DashBarkHuss/dreamphone/(threads)

Thread 1 (2021-04-27):

Dream phone shuts off after a few hours of use

DashBarkHuss, 2021-04-27:
Investigated this issue and seems that the 9V battery can't handle the dream phone.

Tested the current of Dream Phone. Even without LEDs going, it was around 100 mA with used battery, 108mA with a new battery.

108mA is higher than I anticipated. 100 mA would drain a 9V battery, which typically have 500mAh, in 5 hours.

The used 9V battery was drained, volts reading 7.51 V.

I think a solution would be a rechargeable 9V battery that holds at least 1300mAH. (110mA * 12 hours). The highest I'm seeing is [850mAh](https://www.amazon.com/Rechargeable-Batteries-Pallus-Microphones-Flashlights/dp/B08MXQGN21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). Need to investigate more.

DashBarkHuss, 2021-04-27:
The 850mAh option would just be cutting it and probably turn off right before waking. 850mAh/108mA= 7.87 Hours. But this doesn't factor in the extra current mAh used from LED's blinking.

DashBarkHuss, 2021-04-27:
Options:

-[7.4V 2.2AH rechargeable](https://www.digikey.com/en/products/detail/sparkfun-electronics/PRT-11856/5271296)
-[7.2V 3.25AH rechargable](https://www.digikey.com/en/products/detail/jauch-quartz/LI18650PBF-2S1P-PCM-WIRE/9560970)

I've heard that arduino is best powered by between 12v-7v so these might be ok

DashBarkHuss, 2021-05-02:
To repeat it seems I need a **battery that is:**
- Rechargeable
- 1ah or more
- 7-12V
- should charge within 12 hours in time for night time.

This article on different [types of batteries](https://learn.sparkfun.com/tutorials/battery-technologies) suggested LiPo batteries. I like that they have built intprotection against being discharged too much:
>LiPo batteries can also be harmed by being discharged too far. To protect against this, almost all LiPo batteries have a small safety circuit built into the top of the cell that will shut off the battery if the voltage drops below a certain threshold (usually 3V).

The lipo's they talked about have 3.4 V. To get my required minimum of 7v,  could create a battery bank (_I think, but I am new to that concept_) to add the voltage together. But I did see some 7.4V lipo's on amazon. [Here's one](https://www.amazon.com/Zeee-Batteries-Dean-Style-Connector-Vehicles/dp/B076Z778MJ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) but:

- does it have that safety circuit built in that sparkfun mentioned?
- How long does it take to charge?
- It says it's meant for a car. Is that ok?

DashBarkHuss, 2021-05-06:
Need to test the forward voltage of the led's before getting the 7v bateries. The LED strip is 12v. It works at 9 but 7 may be to low.

DashBarkHuss, 2021-05-07:
The [7.4V lipo's](https://www.amazon.com/Zeee-Batteries-Dean-Style-Connector-Vehicles/dp/B076Z778MJ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) were too expensive and bulky. You had to buy a bulky expensive lipo charger with it. So instead I went with these [9V 800mAh](https://www.amazon.com/dp/B087TPNY2D?psc=1&smid=A2B326YBM4EX4P&ref_=chk_typ_imgToDp) batteries.  The have a built in circuit to prevent overcharging. I will make a battery bank in [parallel](https://www.batterystuff.com/kb/articles/battery-articles/battery-bank-tutorial.html) to get more amp hours out of them.

They are lithium-ion. There's a possibility of combustion. But the built-in circuit will help prevent that. I will also only charge when home. They charge fast and I work at home.

Closed 2021-05-07.

Thread 2 (2021-05-14):

state INDUCE_LUCIDITY clearing message is erratic

DashBarkHuss, 2021-05-14:
The morse code message `subjectsLucidSignal` is supposed to clear when the gap (opposite morse beep) is longer than 4000 millis. But right now it's clearing at weird times.

Here's a segment from the serial output
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

DashBarkHuss, 2021-05-14:
The currentMorseState is defined correctly. So that isn't the issue. But why isn't the current morse state then clearing the `subjectsLucidSignal`?

```
21:38:38.649 -> Signal: 0
21:38:38.649 -> 5752
21:38:38.649 -> NEW_MESSAGE //currentMorseState this is correct
21:38:38.649 -> .
21:38:38.798 -> Signal: 1
21:38:38.798 -> 154
21:38:38.798 -> ..

```

DashBarkHuss, 2021-05-17:
the problem was that the `updateSubjectsLucidSignal` was missing `currentMorseState == NEW_MESSAGE` in the if statement:

```
  } else if (currentMorseState == NEW_CHARACTER || currentMorseState == NEW_WORD|| currentMorseState == NEW_MESSAGE) {
    subjectsLucidSignal = "";
  }
  ```

Closed 2021-05-17.

Thread 3 (2021-05-19):

Does not flicker

DashBarkHuss, 2021-05-19:
Last night, I tested the dream phone and it wouldn't flicker. I turned it on at 11:11pm. At 6:23am I hadn't noticed it go off. I was awake so I tried to trigger it by moving my eyes around. It wouldn't flicker.

DashBarkHuss, 2021-05-19:
One of the battery wires was out when I went to debug it. However this might have unplugged when I moved the device to debug it. Also with that one wire out, it still works when I run it in test mode with minutesUntilSleep set to 0.5.

DashBarkHuss, 2021-05-19:
I couldn't recreate the problem with a shortened minutesUntilSleep time so now I'm trying the regular minutesUntilSleep time of 300 minutes (5hrs) so I will check back after 2:30pm and see if I can get the device to flicker.

DashBarkHuss, 2021-05-19:

Recreated the problem. After letting the machine run the full `minuteUntilSleep` time.
But too me it looks like it's a code problem that can be recreated without
full `minuteUntilSleep` time.

````
09:26:05.035 -> M⸮V⸮⸮Initializing SD card...initialization done.
09:26:06.735 -> waiting 300 minutes
14:26:30.313 -> WAIT_FOR_SLEEP over
14:26:32.504 -> eyemovement detected
14:26:32.504 -> eyemovement detected
14:26:32.504 -> eyemovement detected
….  too long to post, many more “eyemovement detected” logs
14:32:55.042 -> eyemovement detected
14:32:56.364 -> eyemovement detected
```

DashBarkHuss, 2021-05-20:
It's not resetting `delta`, it's just adding to it
```
22:19:26.103 -> delta too big-> reset32408 <--- delta
22:19:26.103 -> rem not retected
22:19:26.279 -> eyemovement detected
22:19:26.279 -> delta too big-> reset32620
22:19:26.279 -> rem not retected
22:20:15.546 -> eyemovement detected
22:20:15.546 -> delta too big-> reset81822
22:20:15.546 -> rem not retected
22:20:15.831 -> eyemovement detected
22:20:15.831 -> delta too big-> reset82112
22:20:15.831 -> rem not retected
22:20:17.811 -> eyemovement detected
22:20:17.811 -> delta too big-> reset84060
22:20:17.811 -> rem not retected
22:20:17.955 -> eyemovement detected
22:20:17.955 -> delta too big-> reset84212
22:20:17.955 -> rem not retected
22:20:22.569 -> eyemovement detected
22:20:22.569 -> delta too big-> reset88820
22:20:22.569 -> rem not retected
22:20:22.715 -> eyemovement detected
22:20:22.715 -> delta too big-> reset88964
22:20:22.715 -> rem not retected
```

DashBarkHuss, 2021-05-21:
I believe I found the culprit:
```c++
else if (delta >= 2 * interval) {
    lastIntervalStart = now; // <--- this line needed to be added

    for (int i = 0; i < 4; i++)  //reset buffer
    {
      eyesMovedBuffer[i] = 0;
    }
  }
}
```

If your eyes moved and then 4 seconds elapsed before the next eye movement, the program would get stuck. The `lastIntervalStart` needed to be set. Since it wasn't, `delta`- the time since the `lastIntervalStart`- only got longer and longer.

Closed 2021-05-21.
